Kapilmeet/PCB-Designing_KICAD/BLUEPILL_ENCODER_BOM.xlsx

bomfinal
Reference | Product | Footprint | Value / Part | Authorerised Vendor buy link | Price of unit | Quantity | Amount (Rs) | Vendor | SKU Number
C1,C2,C3 | 100nf | Capacitor_SMD:C_0603_1608Metric_Pad1.08x0.95mm_HandSolder | 100nF 0603 Surface Mount Multilayer Ceramic Capacitor | https://robu.in/product/100nf-0603-surface-mount-multilayer-ceramic-capacitor/ | 0.36 | 3 | 1.08 | Robu | 594998
C4,C5 | 10uf | Capacitor_SMD:C_0603_1608Metric_Pad1.08x0.95mm_HandSolder | GRM188R61E106KA73J-MURATA 10 µF, 25 V, 0603 | https://robu.in/product/grm188r61e106ka73j-murata-smd-multilayer-ceramic-capacitor-10-%C2%B5f-25-v-0603-1608-metric-%C2%B1-10-x5r-grm-series/ | 9 | 2 | 18 | Robu | R109079
C6 | 22uf | Capacitor_SMD:C_0603_1608Metric_Pad1.08x0.95mm_HandSolder | 22uF 0603 X5R Capacitor | https://evelta.com/22uf-10v-20-x5r-0603-capacitor/ | 5.5 | 1 | 5.5 | Evelta | 110-CL10A226MP8NUNE
C9,C10 | 33pf | Capacitor_SMD:C_0603_1608Metric_Pad1.08x0.95mm_HandSolder | 33pF 50V Ceramic Capacitor | https://sharvielectronics.com/product/33pf-50v-ceramic-capacitor/ | 0.68 | 2 | 1.36 | Sharvi | ST2001CO0471
C11 | 1uf | Capacitor_SMD:C_0603_1608Metric_Pad1.08x0.95mm_HandSolder | 1uF 0603 Surface Mount Ceramic Capacitor | https://robu.in/product/cl10a105ko8nnwc-samsang-16v-1uf-x5r-%C2%B110-0603-multilayer-ceramic-capacitors-mlcc-smd-smt-rohs/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 | 0.36 | 1 | 0.36 | Robu | R172314
D1,D2 | Red smd LEDs | LED_SMD:LED_0603_1608Metric_Pad1.05x0.95mm_HandSolder | SMD LED 0603 (Red/Green) | https://robu.in/product/xl-1608vrc-06-xinglight-5ma-90mcd-red-lens-615nm630nm-positive-stick-red-120-75mw-2-7v3-3v-0603-led-indication-discrete-rohs/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 | 1.4 | 2 | 2.8 | Robu | R199109
J1 | HeaderPin_01x03 | Connector_PinHeader_2.54mm:PinHeader_1x03_P2.54mm_Vertical | 3-Pin Male Header 2.54mm | https://robu.in/product/1x40-berg-strip-male-connector/ | - | 1 | - | Robu | 470829
J2 | HeaderPin_01x04 | Connector_PinHeader_2.54mm:PinHeader_1x04_P2.54mm_Vertical | 4-Pin Male Header 2.54mm | https://robu.in/product/1x40-berg-strip-male-connector/ | - | 1 | - | Robu | 470829
J3 | USB_C_Receptacle_USB2.0_16P | Connector_USB:USB_C_Receptacle_GCT_USB4105-xx-A_16P_TopMnt_Horizontal | 16 Pin C Type USB Connector - SMD Package | https://sharvielectronics.com/product/16-pin-c-type-usb-connector-smd-package/ | 17.45 | 1 | 17.45 | Sharvi | ST2103SD0931
J4 | HeaderPin_01x08 | Connector_PinHeader_2.54mm:PinHeader_1x08_P2.54mm_Vertical | 8-Pin Male Header 2.54mm | https://robu.in/product/1x40-berg-strip-male-connector/ | 8 | 1 | 8 | Robu | 470829
R1,R9 | 330Ω | Resistor_SMD:R_0603_1608Metric_Pad0.98x0.95mm_HandSolder | 330 Ohm 1/4W 0603 Chip Resistor | https://sharvielectronics.com/product/330-ohm-1-10-watt-resistor-1-tolerance-cr-03ftp-330r-0603-package/ | 0.75 | 2 | 1.5 | Sharvi | ST2009SD0412
R2,R3 | 10k | Resistor_SMD:R_0603_1608Metric_Pad0.98x0.95mm_HandSolder | 10k Ohm 1/4W 0603 SMDResistor | https://sharvielectronics.com/product/10k-ohm-1-10-watt-smd-resistor-1-tolerance-rc0603fr-0710kl-0603-package/ | 0.85 | 2 | 2.25 | Sharvi | ST2009SD0393
R4 | 1.5k | Resistor_SMD:R_0603_1608Metric_Pad0.98x0.95mm_HandSolder | 1.5k Ohm 1/4W 0603 SMD Resistor | https://sharvielectronics.com/product/1-5k-ohm-1-10-watt-resistor-1-tolerance-0603saf1501t5e-0603-package/ | 0.95 | 1 | 0.95 | Sharvi | ST2009SD0389
R5,R8 | 5k1 | Resistor_SMD:R_0603_1608Metric_Pad0.98x0.95mm_HandSolder | 5.1k Ohm 1/4W 0603 SMD Resistor | https://sharvielectronics.com/product/5-1k-ohm-1-10-watt-resistor-1-tolerance-rc0603fr-075k1l-0603-package/ | 0.85 | 2 | 2.25 | Sharvi | ST2009SD0557
R6,R7 | 4k7 | Resistor_SMD:R_0603_1608Metric_Pad0.98x0.95mm_HandSolder | 4.7k Ohm 1/4W 0603 SMD Resistor | https://sharvielectronics.com/product/4-7k-ohm-1-10-watt-resistor-1-tolerance-0603saf4701t5e-0603-package/ | 0.85 | 2 | 1.7 | Sharvi | ST2009SD0415
SW1 | RESET_SWITCH | TS09-stm32_reset_original_button:SW_TS09-63-25-R-260-SMT-TR | 2Pin SMD Tactile Switch | https://sharvielectronics.com/product/3x6x2-5mm-2pin-smd-tactile-switch/ | 6.54 | 1 | 6.54 | Sharvi | ST2009SD0587
U1 | STM32F103C8T6 | Package_QFP:LQFP-48_7x7mm_P0.5mm | STM32F103C8T6 ARM Microcontroller LQFP-48 | https://sharvielectronics.com/product/stm32f103c8t6-arm-microcontroller-lqfp-48-package/ | 118.75 | 1 | 118.75 | Sharvi | ST2103SD0969
U2 | AMS1117-3.3V | Package_TO_SOT_SMD:SOT-223-3_TabPin2 | AMS1117-3.3V, 1A, SOT-223 Voltage Regulator IC | https://robu.in/product/ams1117-3-3v-1a-sot-223-voltage-regulator-ic-pack-of-5-ics/ | 9 | 1 | 9 | Robu | 162032
U4 | AS5600L-ASOM | ul_AS5600L-ASOM:AS5600L-ASOM_AMS | Magnetic encoder sensor module AS5600 | https://robu.in/product/as5600-asom-ams-0360-soic-8-position-sensors-rohs/ | 166 | 1 | 166 | Robu | R182262
Y2 | 8Mz CRYSTAL | ABM3-8.000MHZ-D2Y-T__ABRACON_8MHz_crystral:XTAL_ABM3-8.000MHZ-D2Y-T | YSX530GA 8MHZ 20PF 10PPM 2Pad SMD/SMT Crystal | https://evelta.com/ysx530ga-8mhz-20pf-10ppm-2pad-smd-smt-crystal/ | 48.32 | 1 | 48.32 | Evelta | YSX530GA
