Kapilmeet/PCB-Designing_KICAD/BLUEPILL_ENCODER.kicad_pcb

## KiCad design BLUEPILL_ENCODER.kicad_pcb (2026-02-20)

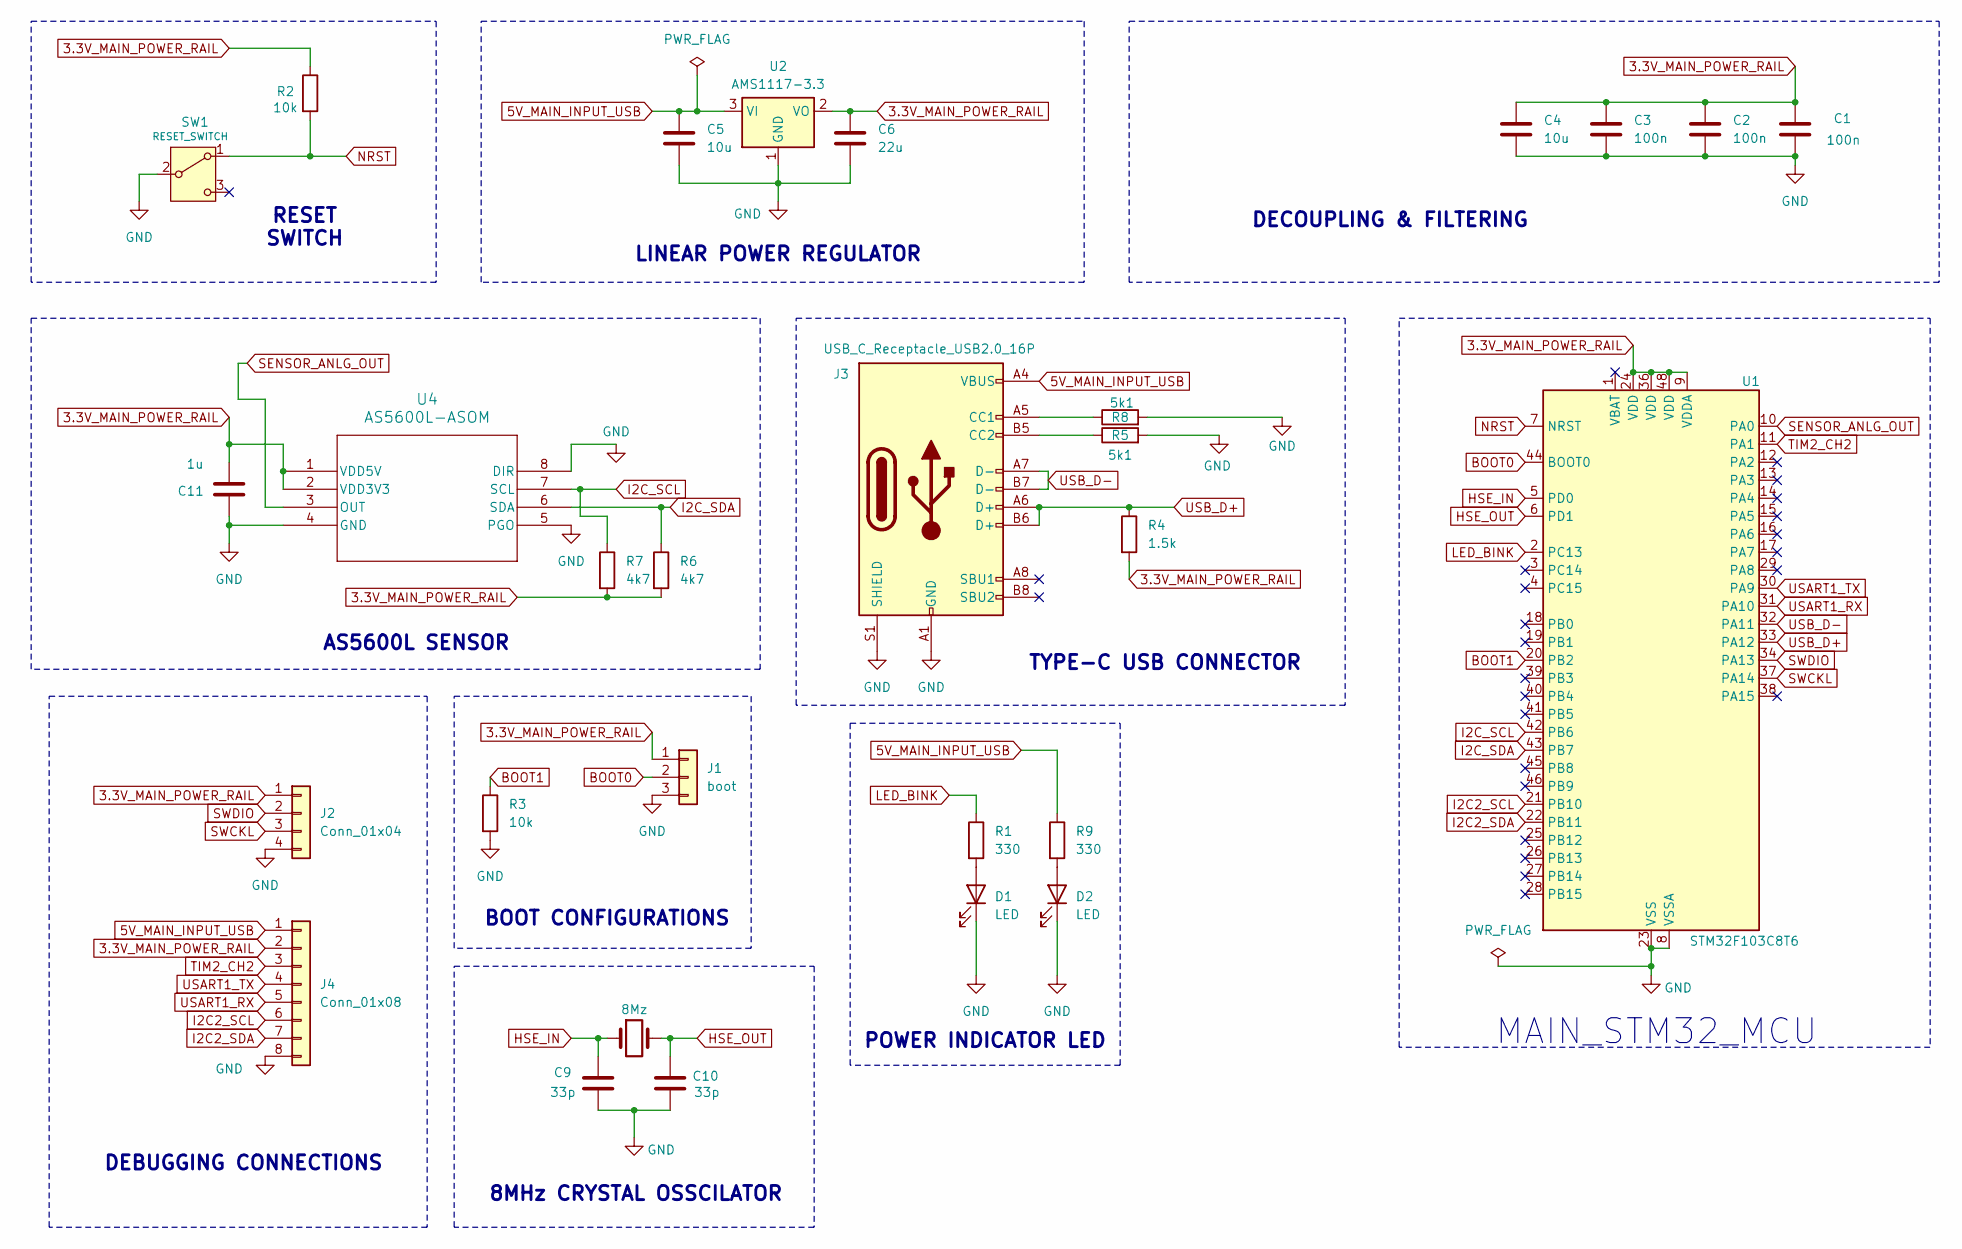
[picture p1: schematic BLUEPILL_ENCODER.kicad_sch]

Parts:
C1, C2, C3: 100n; C_0603_1608Metric_Pad1.08x0.95mm_HandSolder
C4, C5: 10u; C_0603_1608Metric_Pad1.08x0.95mm_HandSolder
C6: 22u; C_0603_1608Metric_Pad1.08x0.95mm_HandSolder
C9, C10: 33p; C_0603_1608Metric_Pad1.08x0.95mm_HandSolder
C11: 1u; C_0603_1608Metric_Pad1.08x0.95mm_HandSolder
D1, D2: LED; LED_0603_1608Metric_Pad1.05x0.95mm_HandSolder
J1: boot; PinHeader_1x03_P2.54mm_Vertical
J2: Conn_01x04; PinHeader_1x04_P2.54mm_Vertical
J3: USB_C_Receptacle_USB2.0_16P; USB_C_Receptacle_GCT_USB4105-xx-A_16P_TopMnt_Horizontal
J4: Conn_01x08; PinHeader_1x08_P2.54mm_Vertical
R1, R9: 330; R_0603_1608Metric_Pad0.98x0.95mm_HandSolder
R2, R3: 10k; R_0603_1608Metric_Pad0.98x0.95mm_HandSolder
R4: 1.5k; R_0603_1608Metric_Pad0.98x0.95mm_HandSolder
R5, R8: 5k1; R_0603_1608Metric_Pad0.98x0.95mm_HandSolder
R6, R7: 4k7; R_0603_1608Metric_Pad0.98x0.95mm_HandSolder
SW1: RESET_SWITCH; SW_TS09-63-25-R-260-SMT-TR
U1: STM32F103C8T6; LQFP-48_7x7mm_P0.5mm
U2: AMS1117-3.3; SOT-223-3_TabPin2
U4: AS5600L-ASOM; AS5600L-ASOM_AMS
Y2: 8Mz; XTAL_ABM3-8.000MHZ-D2Y-T

Connections:
3.3V_MAIN_POWER_RAIL: C1.1, C2.1, C3.1, C4.1, C6.1, C11.2, J1.1, J2.1, J4.2, R2.1, R4.2, R6.2, R7.2, U1.9 (VDDA), U1.24 (VDD), U1.36 (VDD), U1.48 (VDD), U2.2 (VO), U4.1 (VDD5V), U4.2 (VDD3V3)
5V_MAIN_INPUT_USB: C5.1, J3.A4 (VBUS), J3.A9 (VBUS), J3.B4 (VBUS), J3.B9 (VBUS), J4.1, R9.1, U2.3 (VI)
BOOT0: J1.2, U1.44 (BOOT0)
BOOT1: R3.1, U1.20 (PB2)
GND: C1.2, C2.2, C3.2, C4.2, C5.2, C6.2, C9.2, C10.2, C11.1, D1.1 (K), D2.1 (K), J1.3, J2.4, J3.A1 (GND), J3.A12 (GND), J3.B1 (GND), J3.B12 (GND), J3.S1 (SHIELD), J4.8, R3.2, R5.2, R8.2, SW1.2 (B), U1.8 (VSSA), U1.23 (VSS), U1.35 (VSS), U1.47 (VSS), U2.1 (GND), U4.4 (GND), U4.5 (PGO), U4.8 (DIR)
HSE_IN: C9.1, U1.5 (PD0), Y2.1
HSE_OUT: C10.1, U1.6 (PD1), Y2.2
I2C2_SCL: J4.6, U1.21 (PB10)
I2C2_SDA: J4.7, U1.22 (PB11)
I2C_SCL: R7.1, U1.42 (PB6), U4.7 (SCL)
I2C_SDA: R6.1, U1.43 (PB7), U4.6 (SDA)
LED_BINK: R1.1, U1.2 (PC13)
NRST: R2.2, SW1.1 (A), U1.7 (NRST)
unnamed: D1.2 (A), R1.2
unnamed: D2.2 (A), R9.2
unnamed: J3.A5 (CC1), R8.1
unnamed: J3.B5 (CC2), R5.1
SENSOR_ANLG_OUT: U1.10 (PA0), U4.3 (OUT)
SWCKL: J2.3, U1.37 (PA14)
SWDIO: J2.2, U1.34 (PA13)
TIM2_CH2: J4.3, U1.11 (PA1)
USART1_RX: J4.5, U1.31 (PA10)
USART1_TX: J4.4, U1.30 (PA9)
USB_D+: J3.A6 (D+), J3.B6 (D+), R4.1, U1.33 (PA12)
USB_D-: J3.A7 (D-), J3.B7 (D-), U1.32 (PA11)

Notes on the sheet:
RESET SWITCH
8MHz CRYSTAL OSSCILATOR
DECOUPLING & FILTERING
POWER INDICATOR LED
DEBUGGING CONNECTIONS
MAIN_STM32_MCU
LINEAR POWER REGULATOR
AS5600L SENSOR
TYPE-C USB CONNECTOR
BOOT CONFIGURATIONS

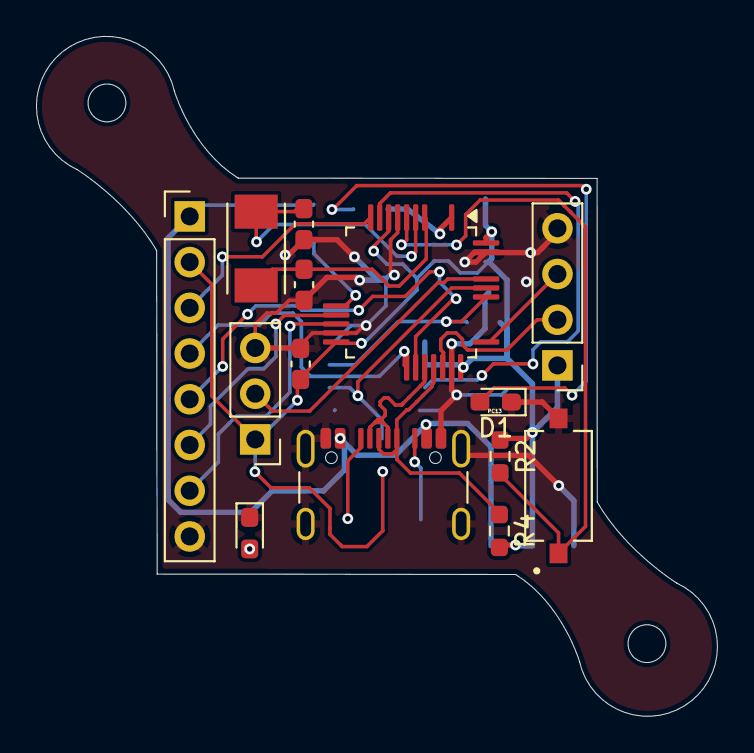
[picture p2: board BLUEPILL_ENCODER.kicad_pcb from above]

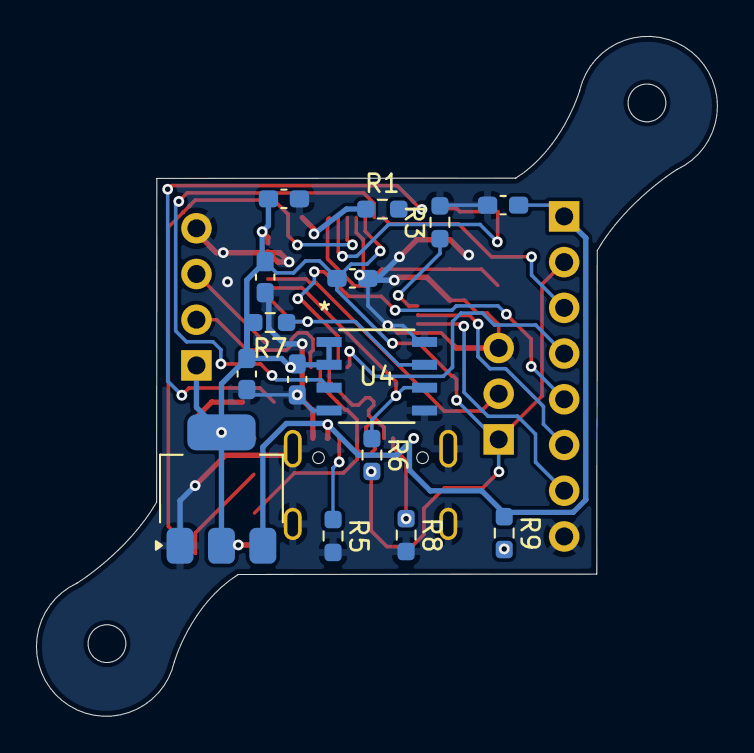
[picture p3: board BLUEPILL_ENCODER.kicad_pcb from below]

Board: 2 copper layers, 37.8 x 37.8 mm, 29 parts (15 on the bottom side), 25 nets.
