Kapilmeet/PCB-Designing_KICAD/(commit log)

2026-02-18 Add files via upload
    Pcb is ready, free from critical errors
    Ready for manufacturing
    [BLUEPILL_ENCODER.kicad_pcb, BLUEPILL_ENCODER.kicad_sch]
2026-02-20 Add files via upload
    SIGNIFICANTLY REDUCED TRACE LENGTH OF I2C PULL-UPs
    AND ERRORS RECTIFIED
    [BLUEPILL_ENCODER.kicad_pcb, BLUEPILL_ENCODER.kicad_sch]
2026-02-20 Add files via upload
    Bill of materials file
    [BLUEPILL_ENCODER_BOM.xlsx]
2026-02-20 Add files via upload
    ADJUSTMENTS DONE IN SOME VIAs near the STM32 chip
